LK-best/DoorGuardian/DoorGuardian_QR.png

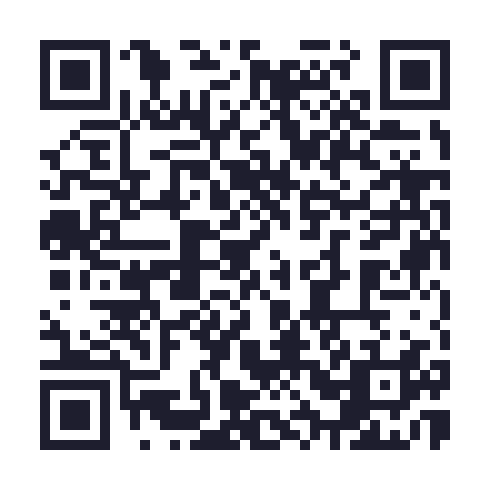
DoorGuardian_QR.png
