LK-best/DoorGuardian/mobile/DoorGuardian_QR.png

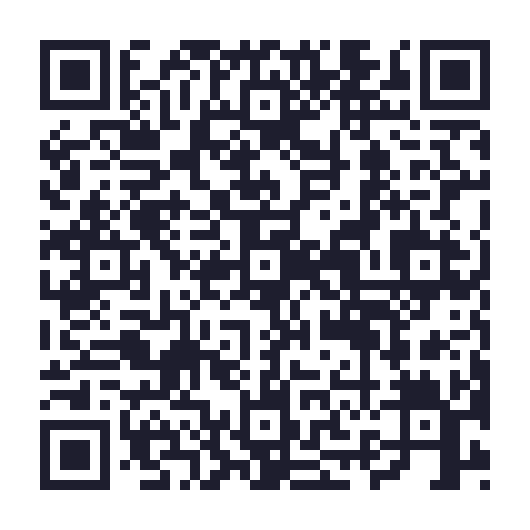
mobile/DoorGuardian_QR.png
