LK-best/DoorGuardian/(commit log)

2026-10-04 Добавлен requirements.txt для Render
2026-10-05 Модернизация мобильного приложения
2026-10-07 доработка
2026-10-07 Настольная панель: карточки вместо вкладок, окно отладки, отправка SMS
    - main.py переписан: одно окно с карточками (подключение, состояние, питание,
    оповещения и таймеры, журнал событий) в оформлении мобильного приложения
    - отдельное окно «Отладка»: светодиод, зумер, модуль GSM, отправка SMS и
    монитор порта с командами TX и ответами устройства
    - состояние охраны и двери берётся из телеметр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
2026-10-14 Конфиг Flet APK (com.door.DoorGuardian) и сводка рынка умного дома
    Полный pyproject.toml с секцией [project], bleak и Android BLE permissions;
    сборка APK описана в mobile/README.md. Документ docs/smart-home-ru.md —
    сравнение цен и место DoorGuardian (октябрь 2026).
2026-10-29 Датчик света
2026-11-09 доработка задания и README
2026-11-09 датчик для двери
2026-11-09 проверка
2026-11-09 Егор, убери этот прямоугольник в main_2.py
